Darkone83/EOS/Tools/readme.md

# Eos — Tools

Host-side tooling for building, flashing, and maintaining an Eos modchip. Four tools:

| Tool | What it's for | Who uses it |
|---|---|---|
| **`Recovery/`** | Reflash / un-brick a board over USB — bitstream, BIOS, loader, XbDiag | **End users** |
| **`eos_pack.py`** | Legacy PrometheOS 1.5.x / LZ4 image packer | Chip prep / dev |
| **`eos_pack_v2.py`** | PrometheOS 1.6+ / LZX image packer | Chip prep / dev |
| **`gen_hud.py`** | Regenerate the HDMI serve-HUD gateware | Firmware dev |

---

## Recovery/  — end-user reflash & un-brick

A point-and-click app that writes the Nano 20K's on-board flash over USB. This is the one you
hand to an end user: it recovers a **bricked bitstream** or a **bad BIOS** without an external
programmer, because the Nano's USB-JTAG bridge still works even when the FPGA design is dead.

```
Recovery/
  eos_recovery.py       the GUI
  openFPGALoader.exe    bundled programmer
  *.dll                 its runtime (libusb, libftdi1, libhidapi, zlib, MinGW)
```

**It's self-contained.** The programmer and every DLL it needs ship in this folder, so it runs
on a clean Windows machine with nothing installed but Python and PySide6 — or nothing at all,
if you freeze it.

**Run it**

```bash
pip install pyside6
python eos_recovery.py
```

Or freeze to a no-Python distributable:

```bash
pyinstaller --onedir --windowed --add-data "openFPGALoader.exe;." --add-data "*.dll;." eos_recovery.py
```

### What the four buttons do

Each section is independent, so you recover exactly what's broken.

| Card | Source | Where it lands |
|---|---|---|
| **Bitstream** | a local `.fs` you pick | the FPGA config flash |
| **BIOS** | a local `.bin` you pick | the offset in the box (defaults to `0x200000`) |
| **Loader** | downloaded — `loader.bin` | `0x200000` (bank `0xE`) |
| **XbDiag Lite** | downloaded — `xbdlite.bin` | `0x400000` (bank `0xD`) |

The two download cards need no file at all — they pull the current image straight from the
Darkone server (`http://darkone83.myddns.me:8008/EOS/`), flash it, and clean up after
themselves. Use them when you've got nothing to hand, or when you just want the current build.
They need an internet connection; everything else works offline.

Under the hood the two local cards run:

- **Bitstream** → `openFPGALoader -b tangnano20k -f <eos.fs>`
- **BIOS** → `openFPGALoader -b tangnano20k --external-flash -o <offset> <eos.bin>`

The app detects the board, streams the programmer's output live, and shows a clear pass/fail
banner.

> **The Loader card overwrites your BIOS.** `loader.bin` is the full image and lands at
> `0x200000` — the same place the BIOS card writes — so any banks you've flashed go with it.
> The app asks you to confirm before it starts. XbDiag writes to `0x400000`, which is a
> reserved area, so it doesn't ask.

> **Offsets come from the gateware.** `0x200000` is `FLOOR` in `eos_bank_ctrl.v`, and
> `0x400000` is bank `0xD`'s base plus `FLOOR`. If you ever change the bank map in the
> firmware, change the offsets in `eos_recovery.py` to match.

> **Windows driver:** first-time users may need to bind the Nano's JTAG interface to WinUSB
> with **Zadig** before the app can see the board. If Detect says "plug in your board" while a
> board is clearly connected, that's the reason.

---

## eos_pack.py — legacy PrometheOS 1.5 / LZ4 BIOS image packer

Builds a **legacy PrometheOS 1.5.x / LZ4** flashable Eos BIOS image. It takes a **known-good matching 1.5.x template image** (including its kernel and bank geometry) and swaps in **only your launcher XBE**,
LZ4-compressed, into the XeniumOS bank at `0x100000`. Everything else in the image stays
byte-for-byte identical, so the kernel always finds the XBE where it expects it. The one
variable is your XBE.

For the legacy 1.5.x format, the XBE region runs `0x100000`–`0x180000`, so the descriptor plus the compressed XBE has to
fit in **512 KB**. The kernel sits at `0x180000`. The output is the full image you flash to the
BIOS offset.

**Requirements:** `pip install lz4` (legacy packer only).

**Usage**

```bash
# Pack your loader XBE into a template -> flashable image
python eos_pack.py pack   <template.bin> <your_loader.xbe> <out.bin>

# Extract the embedded XBE back out
python eos_pack.py unpack <image.bin> <out.xbe>

# Inspect an image: XBE size, magic, md5, and the descriptor
python eos_pack.py verify <image.bin>
```

`pack` is the one that checks itself. After writing the image it decompresses the payload back
out and compares md5 against your original XBE, so a bad compress can't slip through. It also
refuses to write if the compressed XBE won't fit the 512 KB bank, and warns (but continues) if
your file doesn't start with `XBEH`.

`verify` is an inspection command, not a test — it prints the payload's size, magic, and md5,
prints the descriptor, and re-compresses to show you how much of the bank you're using. It
doesn't compare anything, and it doesn't return a failure code. If you want a pass/fail, use
`unpack` and diff against your XBE.

> `pack` zero-fills the rest of the XBE bank before writing the payload. That's fine for a
> whole-image flash, since the programmer erases first.

**Do not use this LZ4 packer with PrometheOS 1.6+ LZX templates.** Use `eos_pack_v2.py` below.

---

## eos_pack_v2.py — PrometheOS 1.6+ / LZX BIOS image packer

Use this tool with a **known-good PrometheOS 1.6 or newer, 2 MiB Xenium-format template**.
PrometheOS 1.6+ stores the embedded XBE as a framed **LZX** stream instead of the older
LZ4 stream. The tool replaces only the two XBE payload ranges; it does not rebuild or
replace the template's bootloader, recovery content, or settings/spare region.

### Image layout

| Offset range | Content | Packer behavior |
|---|---|---|
| `0x100000–0x17FFFF` | Embedded XBE, first 512 KiB | Replaced |
| `0x180000–0x1BFFFF` | Bootloader, 256 KiB | **Preserved** |
| `0x1C0000–0x1DFFFF` | Recovery / other template data, 128 KiB | **Preserved** |
| `0x1E0000–0x1F7FFF` | Embedded XBE continuation, final 96 KiB | Replaced |
| `0x1F8000–0x1FFFFF` | Settings / spare, 32 KiB | **Preserved** |

The logical XBE bank totals **608 KiB** (512 + 96 KiB). Its first eight bytes contain
little-endian uncompressed and compressed sizes, followed by LZX frames (each with a
compressed-size and uncompressed-size pair). The remaining logical bank space is zero-padded.
This differs from the legacy **512 KiB LZ4** region and must not be packed as one continuous
physical range across the bootloader.

### Requirements

- **Windows** and **Python 3**.
- Windows' built-in `makecab.exe` and `expand.exe` on the system path.
- No Python `lz4` dependency or third-party compression DLL for the V2 path.

The compressor uses a **128 KiB LZX window** (`CompressionMemory=17`) and 32 KiB uncompressed
frame chunks, following the format expected by the PrometheOS 1.6+ bootloader.

### Usage

```bash
# Insert a loader XBE into a matching PrometheOS 1.6+ template
python eos_pack_v2.py pack <template.bin> <loader.xbe> <out.bin>

# Extract the embedded loader XBE
python eos_pack_v2.py unpack <image.bin> <out.xbe>

# Inspect and decode the LZX-packed image
python eos_pack_v2.py verify <image.bin>
```

`pack` checks the 2 MiB template size and the 608 KiB XBE capacity, performs a
compression/decompression round-trip, and verifies that the recovered XBE matches the
input. The original bootloader and other protected template ranges are left untouched.

`verify` parses the LZX descriptor and frames and decodes the embedded XBE. It is a format/
decode check; to confirm an image contains your intended XBE, `unpack` it and compare the
extracted file against the intended input.

> **Important:** Keep a known-good copy of the input template and verify the packed image
> before flashing. The packer outputs a complete 2 MiB firmware image, so writing it to
> the BIOS flash region can replace whatever user BIOS data was present in that image.
> The packer's template preservation does not make a whole-image flash nondestructive.

---

## gen_hud.py  — serve-HUD generator

Regenerates the HDMI serve dashboard gateware (`eos_serve_hud.v`). The panels, layout, and
colours all live in **this script**, not in the `.v`. To change the HUD, edit the cell
definitions here and regenerate.

**Never hand-edit `eos_serve_hud.v`.** It happened once: an I2C panel was added straight to the
`.v` and never brought back here, which left the generator 62 cells and 9 module ports behind
the firmware. Running it then produced a module the top level couldn't build against.

Panels: title, BOOT-LINK (rev / D0 / LFRAME aborts), SERVE (bank / rate / last), FLASH ENGINE,
I2C ENGINE (address / version / last command / RX count / select), SDRAM preload bar,
address-space serve map, serve log, stability. Colour attrs: `0` normal · `1` header
(white-on-purple) · `2` purple accent · `3` green · `4` amber · `5` red · `7` dim.

**Requirements:** none (Python standard library)

**Usage**

```bash
# Write straight over the firmware's copy
python gen_hud.py ../Source/src/eos_serve_hud.v

# Or with no argument, drops eos_serve_hud.v in the current folder
python gen_hud.py
```

It prints the cell count when it's done (607 at the time of writing) and warns about any cell
written twice. Six overlaps at row 4 are expected — the D0 field paints blanks and then
overwrites them in the same scan pass. Anything else is a layout bug. A cell outside the
160×45 grid is a hard error.

---

## Requirements summary

| | Needs |
|---|---|
| `Recovery/eos_recovery.py` | `pip install pyside6` (programmer + DLLs bundled). Internet for the Loader / XbDiag cards. |
| `eos_pack.py` (legacy 1.5.x/LZ4) | `pip install lz4` |
| `eos_pack_v2.py` (1.6+/LZX) | Windows + Python 3; built-in `makecab.exe` and `expand.exe` |
| `gen_hud.py` | Python 3 standard library only |

---

## Credits

Eos tooling © Team Resurgent / Darkone83. `openFPGALoader` is the universal FPGA programming
utility by Gwenhael Goavec-Merou and contributors — <https://github.com/trabucayre/openFPGALoader>
— bundled here under its own licence for end-user convenience.
