Darkone83/EOS/images/Bottom.png

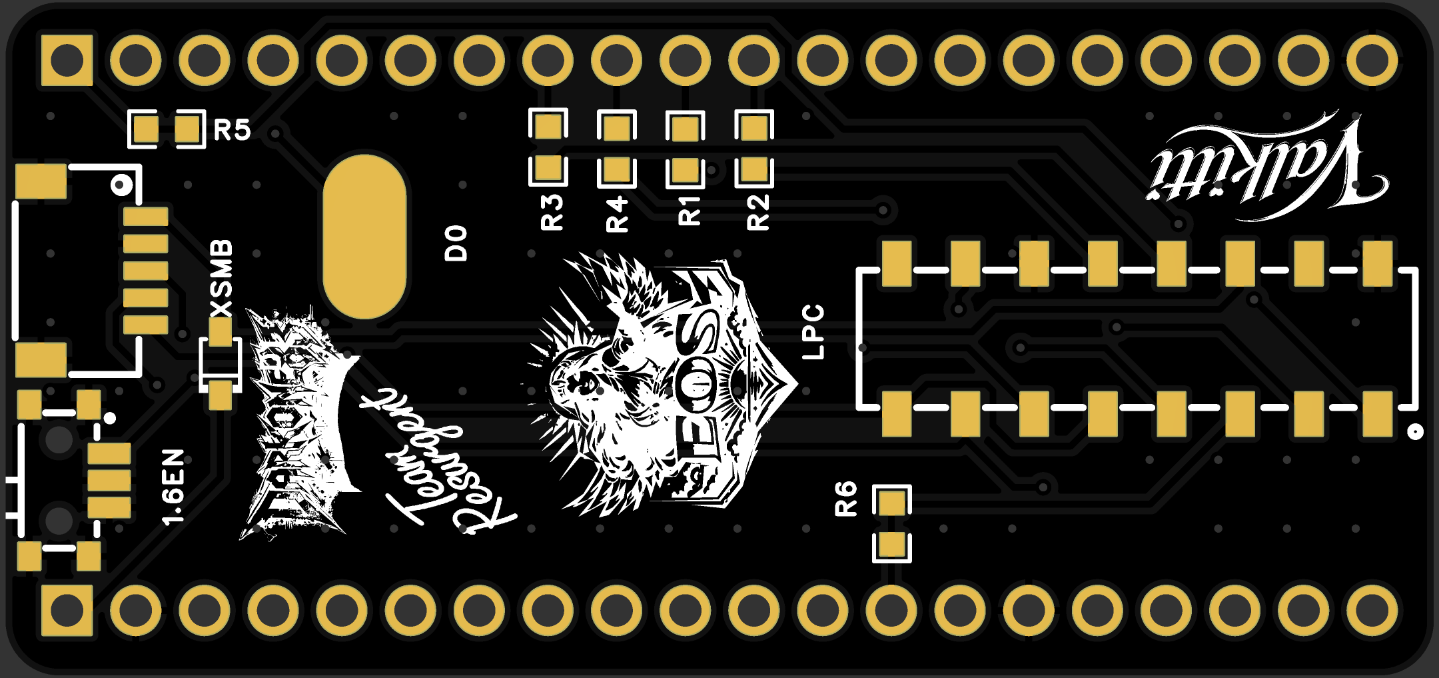
images/Bottom.png
