Darkone83/EOS/images/Bottom_V2.png

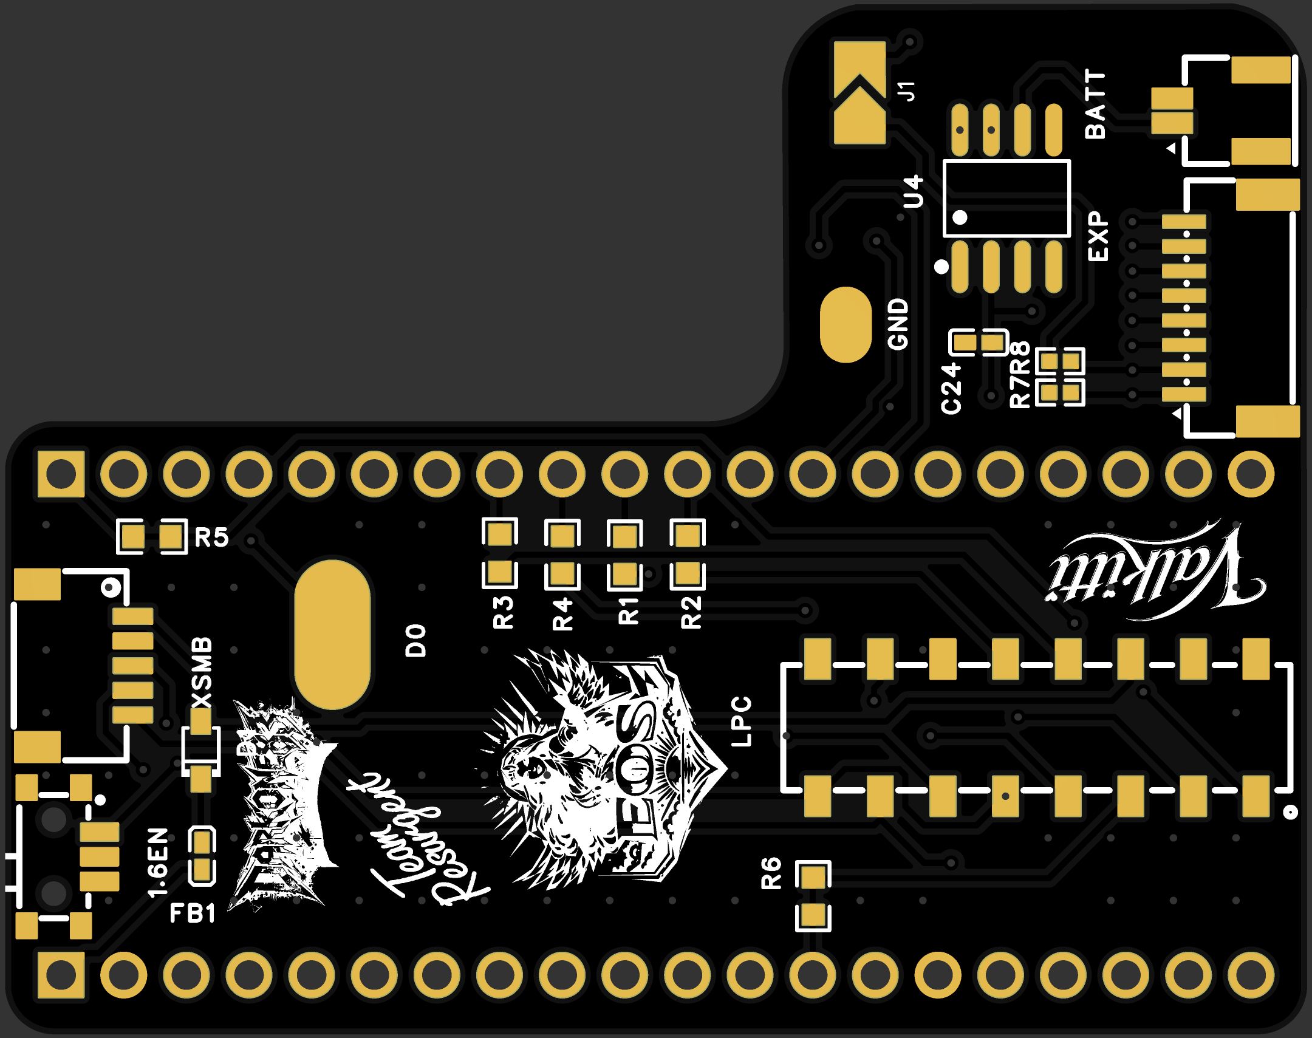
images/Bottom_V2.png
