Darkone83/EOS/images/Top.png

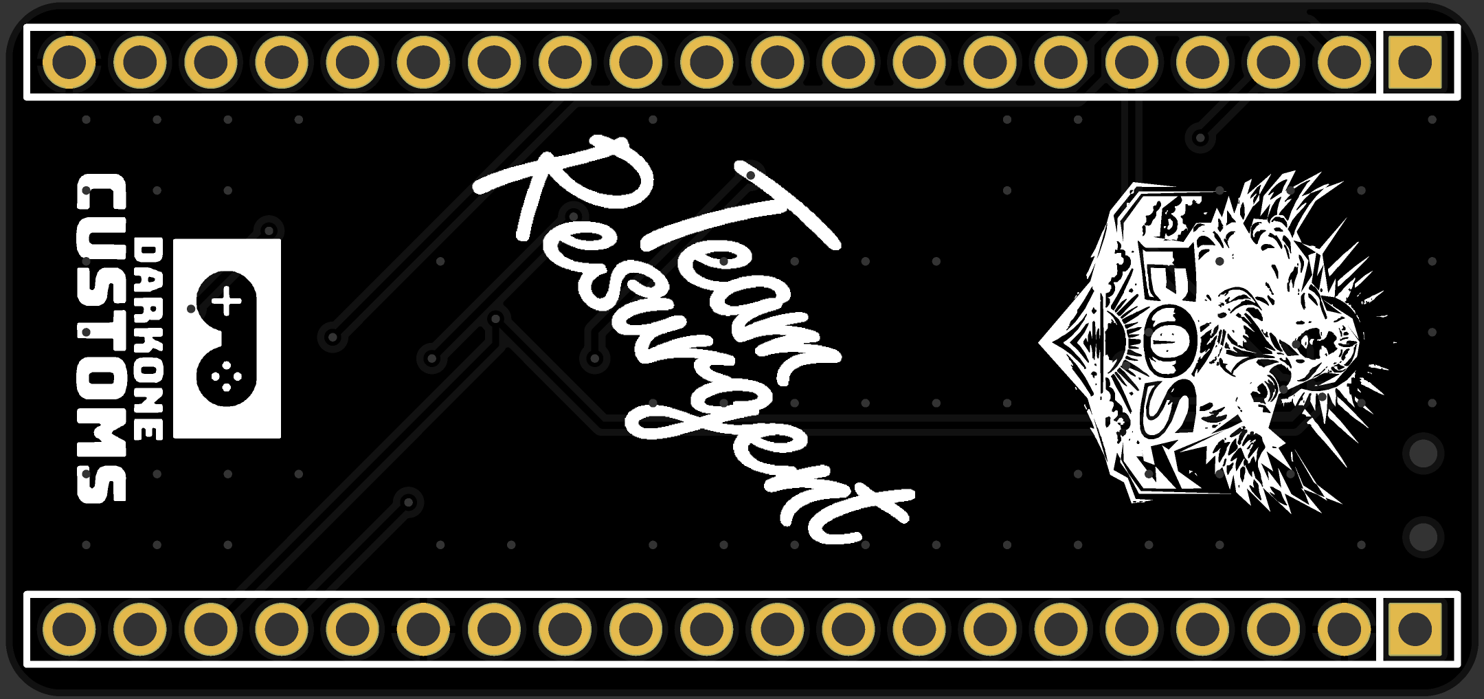
images/Top.png
