Darkone83/EOS/images/Top_V2.png

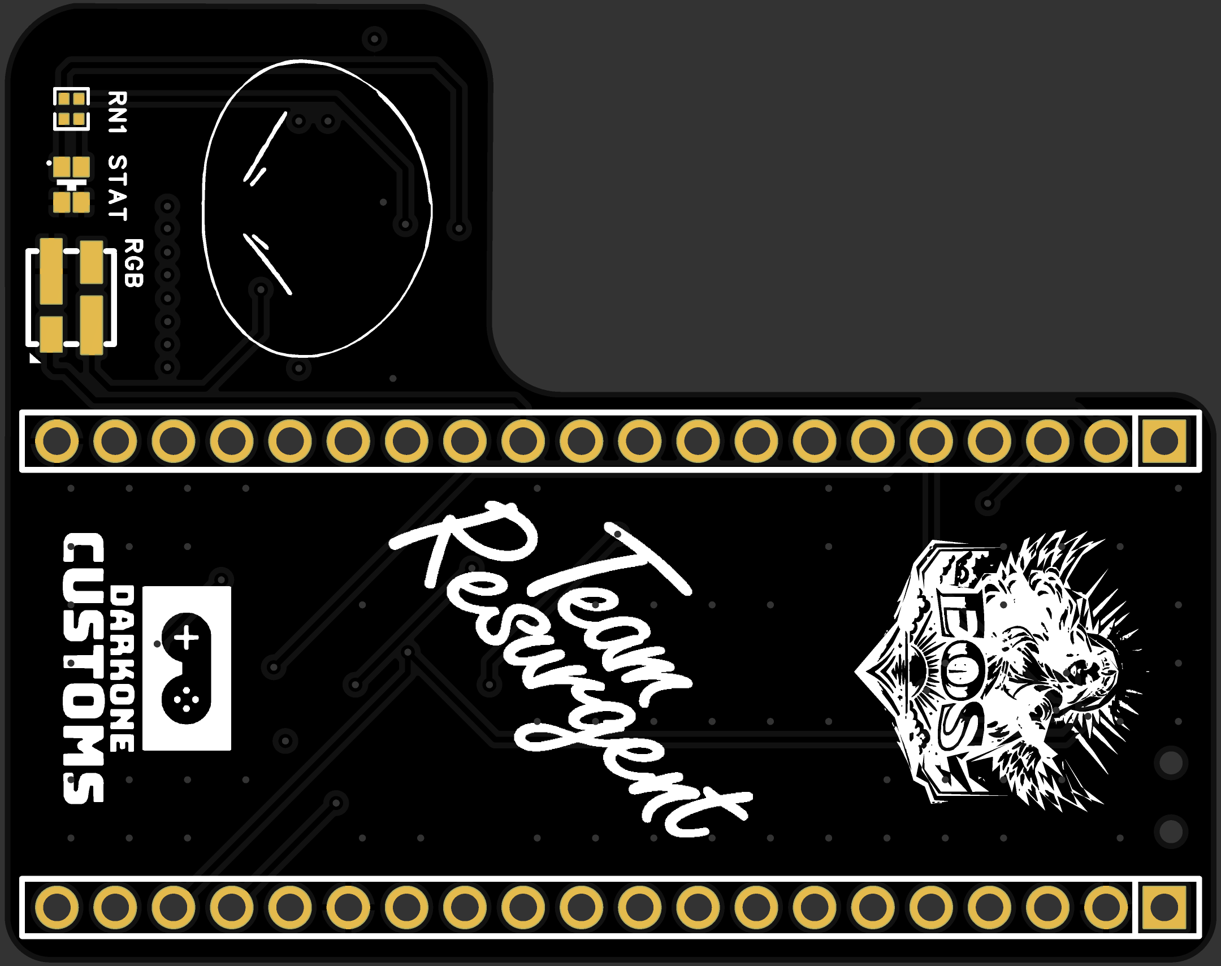
images/Top_V2.png
