Darkone83/EOS/Schematics/EOS_V1.png

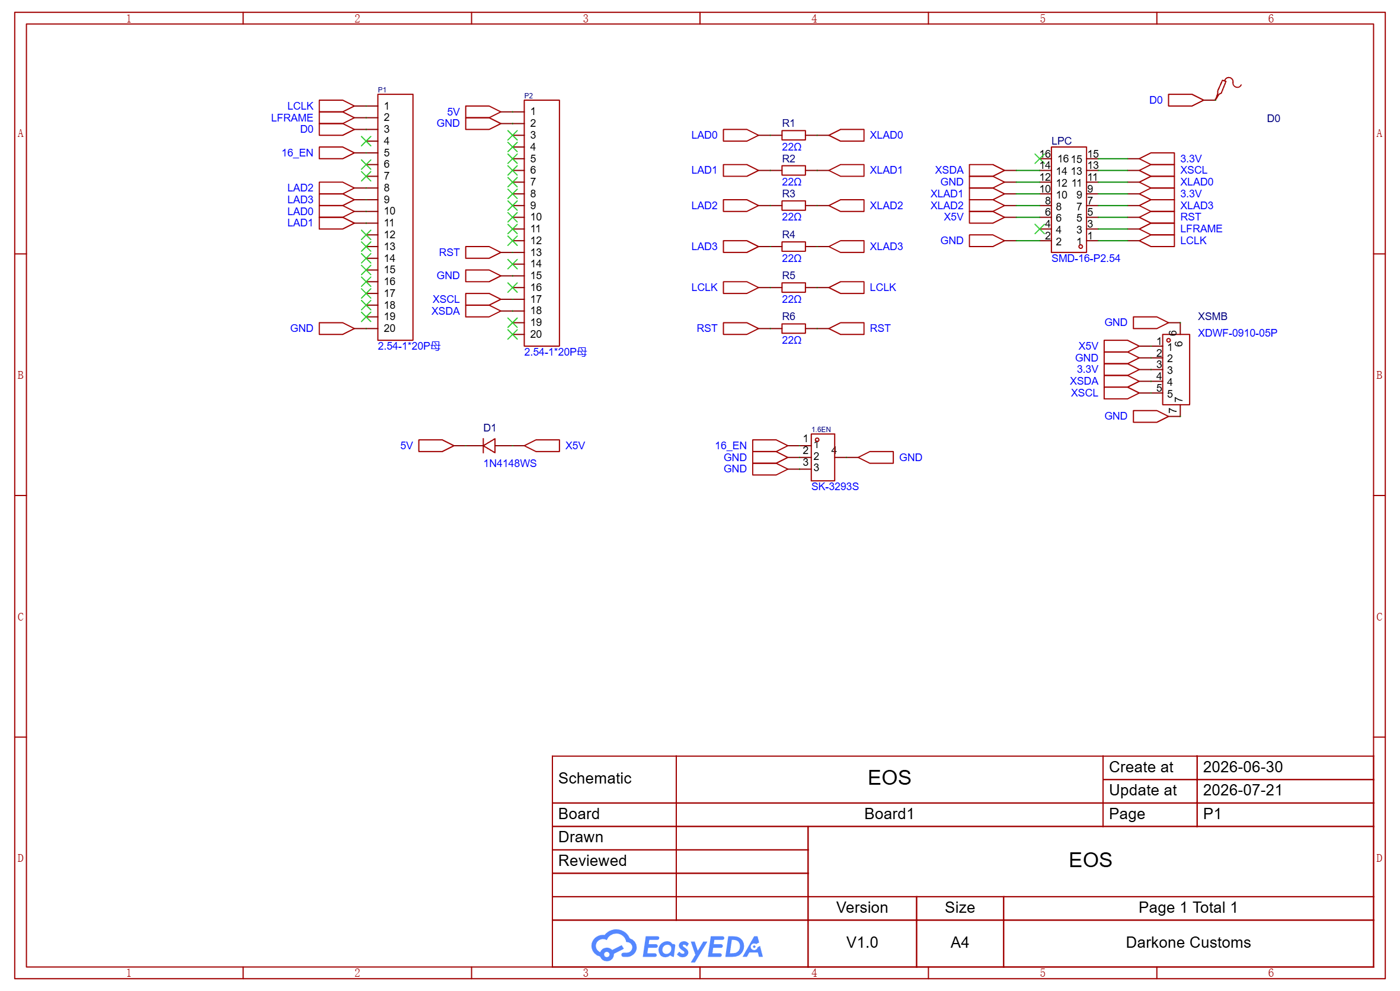
Schematics/EOS_V1.png
