Darkone83/EOS/Schematics/EOS_V2.png

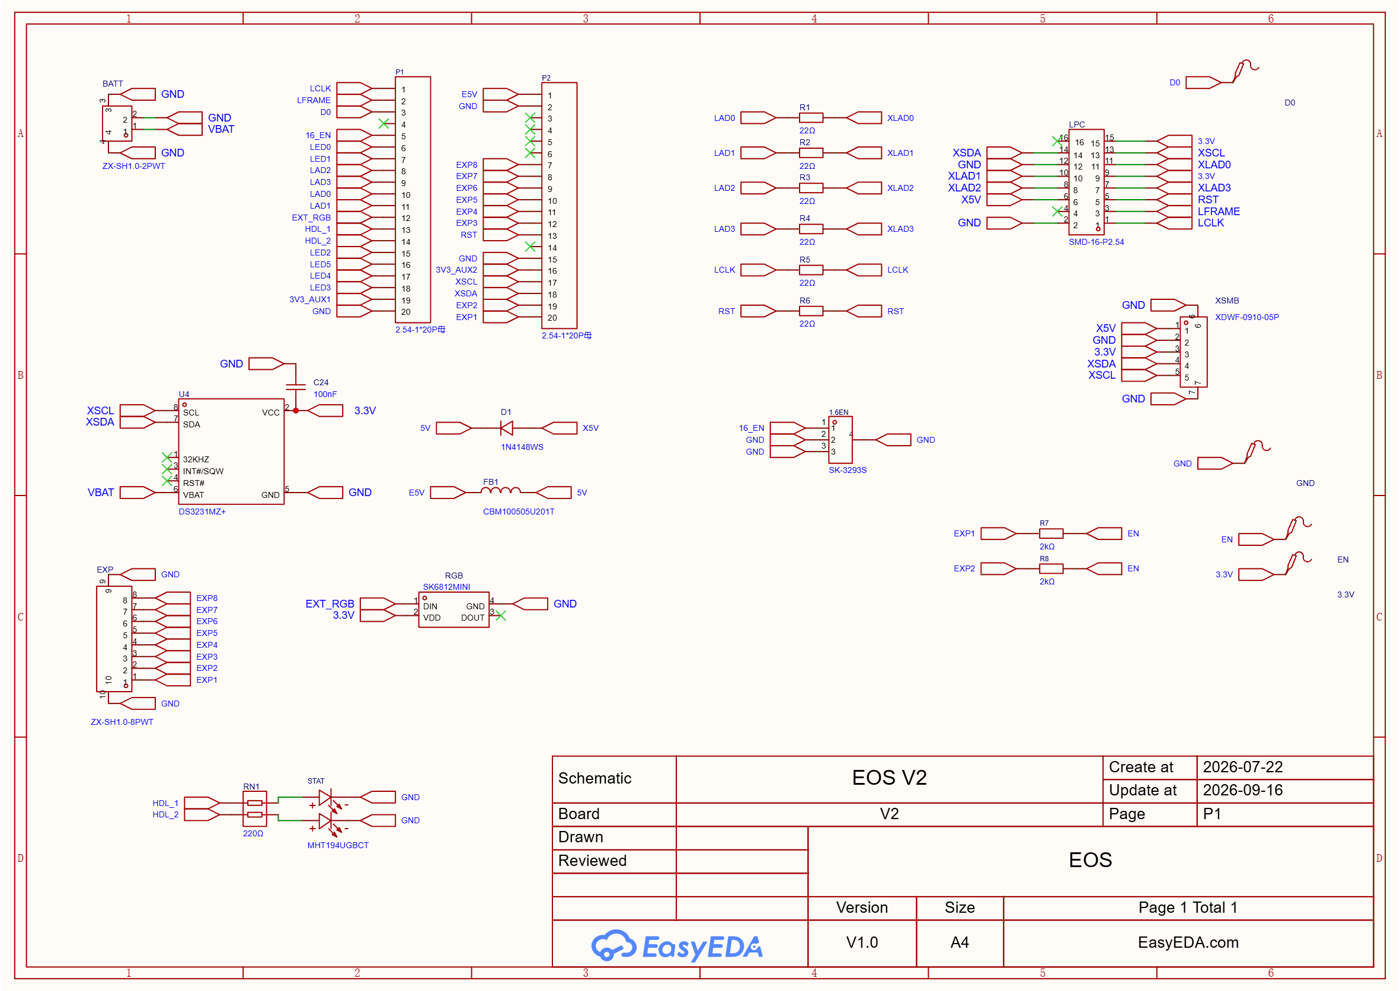
Schematics/EOS_V2.png
