Darkone83/EOS/Gerbers/V2/BOM_V2.xlsx

No. | Quantity | Comment | Designator | Footprint | Value | Manufacturer Part | Manufacturer | Supplier Part | Supplier
1 | 1 | SK-3293S | 1.6EN | SW-SMD_SK-3293S |  | SK-3293S | XKB Connectivity(中国星坤) | C466006 | LCSC
2 | 4 | Test-Point | 3.3V,D0,EN,GND | Test-Point-0.5mm
3 | 1 | ZX-SH1.0-2PWT | BATT | CONN-SMD_2P-P1.00_HX-1.0-2P-WT |  | ZX-SH1.0-2PWT | Megastar(兆星) | C7430444 | LCSC
4 | 1 | 100nF | C24 | C0402 | 100nF | CL05B104KO5NNNC | SAMSUNG(三星) | C1525 | LCSC
5 | 1 | 1N4148WS | D1 | SOD-323_L1.8-W1.3-LS2.5-RD |  | 1N4148WS | CJ(江苏长电/长晶) | C2128 | LCSC
6 | 1 | ZX-SH1.0-8PWT | EXP | CONN-SMD_8P-P1.00_MEGASTAR_ZX-SH1.0-8PWT |  | ZX-SH1.0-8PWT | Megastar(兆星) | C7430450 | LCSC
7 | 1 | CBM100505U201T | FB1 | L0402 |  | CBM100505U201T | FH(风华) | C394402 | LCSC
8 | 1 | SMD-16-P2.54 | LPC | HDR-TH_16P-P2.54-V-F-R2-C8-S2.54-LS6.7 |  | SMD-16-P2.54 |  | C9900001406 | LCSC
9 | 2 | 2.54-1*20P母 | P1,P2 | HDR-TH_20P-P2.54-V-F |  | 2.54-1*20P母 | BOOMELE(博穆精密) | C50984 | LCSC
10 | 6 | 22Ω | R1,R2,R3,R4,R5,R6 | R0603 | 22Ω | RC0603FR-0722RL | YAGEO(国巨) | C107701 | LCSC
11 | 2 | 2kΩ | R7,R8 | R0402 | 2kΩ | 0402WGF2001TCE | UNI-ROYAL(厚声) | C4109 | LCSC
12 | 1 | SK6812MINI | RGB | LED-SMD_4P-L3.7-W3.5-P1.75-BR-SK6812MINI |  | SK6812mini | 欧思科光电 | C2886570 | LCSC
13 | 1 | 220Ω | RN1 | RES-ARRAY-SMD_0402-L1.0-W1.0-BL | 220Ω | YC122-JR-07220RL | YAGEO(国巨) | C1731723 | LCSC
14 | 1 | MHT194UGBCT | STAT | LED-ARRAY-SMD_0605-4P-L1.6-W1.5-BL-1 |  | MHT194UGBCT | MEIHUA(美华) | C2764896 | LCSC
15 | 1 | DS3231MZ+ | U4 | SOIC-8_L4.9-W3.9-P1.27-LS6.0-BL |  | DS3231MZ+ | ADI(亚德诺)/MAXIM(美信) | C722467 | LCSC
16 | 1 | XDWF-0910-05P | XSMB | CONN-SMD_XDWF-0910-05P |  | XDWF-0910-05P | LX(连欣科技) | C7527620 | LCSC
