Darkone83/EOS/Source/src/eos_bank_ctrl.v

// eos_bank_ctrl.v -- Eos bank-management controller (flash erase/program/poll).
// =====================================================================
// Loader flash CONTROL PLANE. Does NOT duplicate the serve path: the 0xEF bank
// register and the logical->physical SERVE translation live in
// eos_sdram_backend.v (hardware-validated). This module owns what the backend
// does not -- writing the flash:
//   * ERASE a bank   (loop 64K block-erase 0xD8 over the bank's size)
//   * PROGRAM a page (0x02, a 256-byte page from the page buffer)
//   * READ a page    (0x03, clock 256 bytes back into the page buffer for host
//                     read-back; cmd_op = 2)
//   * real STATUS poll (0x05, wait WIP bit0 clear after every erase/program)
//   * HARD floor guard: every physical target is FLOOR + bank_base + offset, so
//     it is impossible to address below FLOOR. Chip-erase is not implemented.
// VARIABLE BIOS SIZE: a bank's size comes from its number (256K / 512K / 1MB),
// matching the backend xlate map. ERASE walks (size/64K) blocks; PROGRAM walks
// (size/256) pages. Expansion banks are a later map extension -- the geometry
// functions below are the single place to grow.
// SPI BUS shared with the reader (idle post-preload); taken via bus_req/bus_gnt.
// After a flash, refresh_* hands the region to the backend for SDRAM reload.
// =====================================================================
module eos_bank_ctrl #(
    parameter [23:0]  FLOOR    = 24'h200000,
    parameter integer SCK_DIV  = 2,
    parameter [7:0]   CMD_WREN = 8'h06,
    parameter [7:0]   CMD_PP   = 8'h02,
    parameter [7:0]   CMD_BE   = 8'hD8,
    parameter [7:0]   CMD_RDSR = 8'h05,
    parameter [7:0]   CMD_READ = 8'h03,
    // ---- dynamic bank geometry (Pass 1: FPGA read-only) ----
    // Offsets are relative to FLOOR (same space as bank_base). Blank NOR reads
    // 0xFF so a fresh chip fails the MAGIC check -> legacy static geometry.
    parameter [23:0]  DESC_OFF   = 24'h4C0000,   // descriptor block  (phys 0x6C0000)
    parameter [23:0]  NEWRGN_OFF = 24'h3C0000    // oversized-bank region (phys 0x5C0000)
)(
    input  wire        clk,
    input  wire        cold_rstn,
    // CONTRACT: cmd_bank/cmd_op/cmd_page must be VALID AND STABLE on the cycle
    // before cmd_stb pulses (operands-valid-before-strobe). The loader's LPC
    // decode registers naturally satisfy this; do not derive cmd_stb and cmd_bank
    // from the same combinational decode in the same cycle.
    input  wire        cmd_stb,
    input  wire [1:0]  cmd_op,        // 0=ERASE_BANK 1=PROGRAM_PAGE 2=READ_PAGE
    input  wire [3:0]  cmd_bank,
    input  wire [12:0] cmd_page,
    input  wire        desc_reload,   // pulse (i2c domain): re-read the descriptor block
    input  wire        blk_erase,     // 1 = ERASE only one 64K block at cmd_page's block
    input  wire        pb_wr,
    input  wire [7:0]  pb_addr,
    input  wire [7:0]  pb_din,
    input  wire [7:0]  pb_raddr,      // page-buffer read address (host read-back)
    output wire [7:0]  pb_rdata,      // page-buffer read data
    output reg         busy,
    output reg         done,
    output reg         refused,
    output reg  [7:0]  last_status,
    output reg         refresh_req,
    output reg  [23:0] refresh_base,
    output reg  [23:0] refresh_len,

    // Per-user-slot descriptor export for the SERVE path (eos_sdram_backend).
    // Index [3:0] maps to EF nibbles 0x3..0x6 (bit i = user slot i+1). This lets
    // the backend redirect a normal bank launch (EF 0x3..0x6) to the ext-region
    // SDRAM copy when that slot is an oversized ANCHOR -- no special launch EF.
    output wire [3:0]  ext_anchor,     // 1 = this slot is an oversized anchor
    output wire [7:0]  ext_szc,        // 2 bits per slot: size code (512K/1MB)
    output wire [95:0] ext_base,       // 24 bits per slot: phys base rel FLOOR
    // Bank-LED user colors, packed RGB {R,G,B}. FF,FF,FF = unset (LED off).
    // Read from the descriptor block at boot (and on desc_reload). Blank -> FF.
    output reg  [23:0] bank1_rgb,
    output reg  [23:0] bank2_rgb,
    output reg  [23:0] bank3_rgb,
    output reg  [23:0] bank4_rgb,
    output reg         bus_req,
    input  wire        bus_gnt,
    output reg         flash_cs_n,
    output reg         flash_clk,
    output reg         flash_mosi,
    input  wire        flash_miso,

    // ---- i2c-triggered commit engine (scratch -> flash), gated by i2c ----
    input  wire        commit_go,       // pulse: erase bank + program from scratch + reload
    input  wire [3:0]  commit_bank,     // armed region; physical target derived via bank_base
    input  wire [12:0] commit_pages,    // 256B pages to program from scratch offset 0
    output reg         commit_busy,
    output reg         commit_done,     // 1-cycle pulse on completion
    output reg         commit_err,      // 1 = a sub-op was refused

    // ---- SDRAM scratch read (eos_sdram_backend, same clk_sd domain) ----
    output reg         scr_rd,
    output reg  [20:0] scr_raddr,
    input  wire [7:0]  scr_rdata,
    input  wire        scr_rvalid,
    input  wire        scr_busy
);
    // bank_base is now 24-bit so a config bank can live above the 2MB Xenium
    // range (engine-reachable for erase/program/read; NOT served -- the serve
    // xlate in eos_sdram_backend stays 21-bit / 2MB). Config bank 0xB sits at
    // the top of the managed region, clear of BIOS (0x000000-0x400000) and the
    // XbDiag reserve below it.
    function [23:0] bank_base; input [3:0] b; begin
        case (b)
            4'h1: bank_base = 24'h180000; 4'h2: bank_base = 24'h100000;
            4'h3: bank_base = 24'h000000; 4'h4: bank_base = 24'h040000;
            4'h5: bank_base = 24'h080000; 4'h6: bank_base = 24'h0C0000;
            4'h7: bank_base = 24'h000000; 4'h8: bank_base = 24'h080000;
            4'h9: bank_base = 24'h4D0000; 4'hA: bank_base = 24'h1C0000;   // 0x9 = EOS script region (phys 0x6D0000, free gap)
            4'hB: bank_base = 24'h5F0000;            // CONFIG banks-table (phys 0x7F0000)
            4'hC: bank_base = 24'h5E0000;            // CONFIG settings   (phys 0x7E0000)
            4'hD: bank_base = 24'h200000;            // XbDiag Lite       (phys 0x400000, reserve)
            4'hE: bank_base = 24'h000000;            // LOADER full image (phys 0x200000, slot 0)
            4'h0: bank_base = 24'h3C0000;            // NEW REGION oversized banks (phys 0x5C0000)
            4'hF: bank_base = 24'h4C0000;            // DESCRIPTOR block (phys 0x6C0000)
            default: bank_base = 24'h000000;
        endcase
    end endfunction
    function [23:0] bank_size; input [3:0] b; begin
        case (b)
            4'h2,4'h7,4'h8: bank_size = 24'h080000;  // 512K
            4'h9:          bank_size = 24'h020000;  // EOS script region: 128K (2x 64K blocks)
            4'hD:          bank_size = 24'h1C0000;  // XbDiag: full-image span (28x64K), 2nd slot
            4'hE:          bank_size = 24'h1C0000;  // LOADER: full-image span (28x64K), slot 0
            4'hB,4'hC:      bank_size = 24'h010000;  // CONFIG: one 64K block each
            4'h0:          bank_size = 24'h100000;  // NEW REGION: 1MB oversized area
            4'hF:          bank_size = 24'h010000;  // DESCRIPTOR: one 64K block
            default:        bank_size = 24'h040000;  // 256K
        endcase
    end endfunction

    // ===== i2c-triggered commit supervisor (scratch -> flash) ==============
    // Drives the SPI FSM below via muxed command signals so the flash logic is
    // untouched. commit_bank is the ONLY selector -- the physical range derives
    // from bank_base (FLOOR-guarded), never passed raw, so i2c stays the gate.
    // Sequence: ERASE bank -> per page {fill pbuf from scratch, PROGRAM} -> SYNC.
    // Loader LPC commands are muxed out while commit_active.
    localparam CS_IDLE=3'd0, CS_ERASE=3'd1, CS_FILL=3'd2, CS_PROG=3'd3,
               CS_SYNC=3'd4, CS_DONE=3'd5, CS_ERR=3'd6;
    reg [2:0]  cst;
    reg        commit_active;
    reg [3:0]  cbank;
    reg [12:0] cpages, cpg;
    reg [8:0]  cfill;
    reg [1:0]  cstep;
    reg        sup_cmd_stb, sup_pb_wr;
    reg [1:0]  sup_cmd_op;
    reg [12:0] sup_cmd_page;
    reg [7:0]  sup_pb_addr, sup_pb_din;

    wire        eff_cmd_stb  = commit_active ? sup_cmd_stb  : cmd_stb;
    wire [1:0]  eff_cmd_op   = commit_active ? sup_cmd_op   : cmd_op;
    wire [3:0]  eff_cmd_bank = commit_active ? cbank        : cmd_bank;
    wire [12:0] eff_cmd_page = commit_active ? sup_cmd_page : cmd_page;
    wire        eff_pb_wr    = commit_active ? sup_pb_wr    : pb_wr;
    wire [7:0]  eff_pb_addr  = commit_active ? sup_pb_addr  : pb_addr;
    wire [7:0]  eff_pb_din   = commit_active ? sup_pb_din   : pb_din;

    // ===== dynamic bank descriptor (Pass 1: read-only) =====================
    // Loaded once at boot from the descriptor block. When invalid (blank flash),
    // descriptor_valid=0 and ALL geometry falls back to the static tables below,
    // so behavior is byte-identical to the legacy design. Only user slots 1..4
    // are governed by the descriptor; loader/xbdiag/config always use statics.
    //
    // Per-slot entry (from flash, 8 bytes each):
    //   [0] state     0=free 1=native256 2=oversized-anchor 3=shadowed
    //   [1] size_code 0=256K 1=512K 2=1M
    //   [4..6] phys_base (24-bit, relative to FLOOR, little-endian)
    localparam DS_FREE=2'd0, DS_NATIVE=2'd1, DS_ANCHOR=2'd2, DS_SHADOW=2'd3;

    reg        descriptor_valid;
    reg [1:0]  slot_state [1:4];
    reg [1:0]  slot_szc   [1:4];
    reg [23:0] slot_base  [1:4];   // relative to FLOOR

    // Export the parsed slots for the serve path. slot_state[1..4] correspond to
    // EF nibbles 0x3..0x6 (descriptor slots 0..3). Only valid when descriptor_valid.
    assign ext_anchor[0] = descriptor_valid && (slot_state[1] == DS_ANCHOR);
    assign ext_anchor[1] = descriptor_valid && (slot_state[2] == DS_ANCHOR);
    assign ext_anchor[2] = descriptor_valid && (slot_state[3] == DS_ANCHOR);
    assign ext_anchor[3] = descriptor_valid && (slot_state[4] == DS_ANCHOR);
    assign ext_szc  = {slot_szc[4],  slot_szc[3],  slot_szc[2],  slot_szc[1]};
    assign ext_base = {slot_base[4], slot_base[3], slot_base[2], slot_base[1]};

    // size_code -> byte length
    function [23:0] szc_len; input [1:0] c; begin
        case (c)
            2'd0: szc_len = 24'h040000;   // 256K
            2'd1: szc_len = 24'h080000;   // 512K
            2'd2: szc_len = 24'h100000;   // 1M
            default: szc_len = 24'h040000;
        endcase
    end endfunction

    // Is this a user slot (1..4) the descriptor is allowed to govern?
    wire eff_is_user_slot = (eff_cmd_bank >= 4'd1) && (eff_cmd_bank <= 4'd4);
    wire [2:0] eff_slot_ix = eff_cmd_bank[2:0];   // 1..4

    // Descriptor-resolved geometry for the selected user slot (valid only when
    // descriptor_valid && eff_is_user_slot). Occupied = native or anchor.
    wire       eff_slot_occupied = eff_is_user_slot &&
                   ((slot_state[eff_slot_ix] == DS_NATIVE) ||
                    (slot_state[eff_slot_ix] == DS_ANCHOR));
    wire [23:0] dyn_base = FLOOR + slot_base[eff_slot_ix];
    wire [23:0] dyn_size = (slot_state[eff_slot_ix] == DS_NATIVE)
                             ? 24'h040000
                             : szc_len(slot_szc[eff_slot_ix]);

    // Use the descriptor ONLY when it is valid, the bank is a user slot, and that
    // slot is actually occupied. Everything else -> legacy static tables. This
    // guarantees: blank descriptor -> pure legacy; non-user banks -> pure legacy;
    // selecting a free/shadowed slot -> legacy (harmless; the host gates real ops).
    wire use_dynamic = descriptor_valid && eff_is_user_slot && eff_slot_occupied;

    wire [23:0] sel_phys_base = use_dynamic ? dyn_base
                                            : (FLOOR + bank_base(eff_cmd_bank));
    wire [23:0] sel_size      = use_dynamic ? dyn_size
                                            : bank_size(eff_cmd_bank);
    wire [8:0]  n_blocks      = sel_size[23:16];   // size / 64K
    wire        op_below_floor = (sel_phys_base < FLOOR);

    reg [7:0] pbuf [0:255];
    // External fill (program) writes via pb_wr; internal fill (read-back) writes
    // captured flash bytes via rd_we. The two never overlap (fill precedes GO;
    // read-capture happens during a READ op). pb_rdata streams the buffer back.
    reg        rd_we; reg [7:0] rd_waddr, rd_wdata;
    always @(posedge clk) begin
        if (eff_pb_wr)  pbuf[eff_pb_addr] <= eff_pb_din;
        else if (rd_we) pbuf[rd_waddr] <= rd_wdata;
    end
    assign pb_rdata = pbuf[pb_raddr];

    localparam integer PERIOD = 2*SCK_DIV;
    reg  [15:0] pc; reg [3:0] bit_i; reg [7:0] tx_byte, rx_byte, sh;
    reg         shift_go, shift_busy, shift_done;
    wire        pc_last = (pc == PERIOD-1);
    wire        sck_hi  = (pc >= SCK_DIV);

    always @(posedge clk or negedge cold_rstn) begin
        if (!cold_rstn) begin
            pc<=0; bit_i<=0; shift_busy<=0; shift_done<=0; flash_clk<=0; flash_mosi<=0; rx_byte<=0; sh<=0;
        end else begin
            shift_done <= 1'b0;
            if (shift_go && !shift_busy) begin
                shift_busy<=1'b1; sh<=tx_byte; bit_i<=4'd0; pc<=0; flash_mosi<=tx_byte[7]; flash_clk<=1'b0;
            end else if (shift_busy) begin
                flash_clk <= sck_hi;
                if (pc==0) flash_mosi <= sh[7];
                if (pc==SCK_DIV) rx_byte <= {rx_byte[6:0], flash_miso};
                if (pc_last) begin
                    pc<=0; sh<={sh[6:0],1'b0};
                    if (bit_i==4'd7) begin shift_busy<=0; shift_done<=1; flash_clk<=0; end
                    else bit_i<=bit_i+1'b1;
                end else pc<=pc+1'b1;
            end
        end
    end

    localparam OP_ERASE = 2'd0, OP_PROG = 2'd1, OP_READ = 2'd2, OP_SYNC = 2'd3;
    localparam S_IDLE=5'd0,S_REQ=5'd1,S_WREN=5'd2,S_WREN2=5'd3,S_CMD=5'd4,
               S_A2=5'd5,S_A1=5'd6,S_A0=5'd7,S_PDATA=5'd8,S_CSUP=5'd9,
               S_POLL0=5'd10,S_POLL1=5'd11,S_POLLC=5'd12,S_NEXT=5'd13,
               S_DONE=5'd14,S_REFUSE=5'd15,S_KICK=5'd16,
               S_RCMD=5'd17,S_RA2=5'd18,S_RA1=5'd19,S_RA0=5'd20,
               S_RDATA=5'd21,S_RCAP=5'd22,S_RCSUP=5'd23,
               // ---- boot-time descriptor load (Pass 1) ----
               S_DBOOT=5'd24,   // wait for bus grant, start read
               S_DCMD=5'd25,S_DA2=5'd26,S_DA1=5'd27,S_DA0=5'd28,
               S_DRD=5'd29,S_DCAP=5'd30,S_DFIN=5'd31,
               // ---- boot-time LED color-block load (after descriptor) ----
               S_LBOOT=6'd32,S_LCMD=6'd33,S_LA2=6'd34,S_LA1=6'd35,S_LA0=6'd36,
               S_LRD=6'd37,S_LCAP=6'd38,S_LFIN=6'd39,
               // ---- SPI transaction guard gaps (diagnostic) ----
               S_WGAP=6'd40,S_PGAP=6'd41;

    reg [5:0]  st, ret; reg [1:0] op_l;
    reg [3:0]  gap_cnt;   // CS-high guard counter between SPI transactions
    reg [23:0] addr_l; reg [8:0] blocks_left; reg [8:0] pbyte;
    reg [23:0] flashed_base, flashed_len;
    reg [8:0]  rd_idx;     // read-back byte counter (0..256)

    // descriptor-load working state
    localparam DESC_BYTES = 7'd64;         // read 64 bytes of the descriptor block
    // Physical descriptor address, byte-sliced for the 0x03 READ command below.
    // Explicit slices instead of >>16 / >>8 / &0xFF so no implicit truncation.
    localparam [23:0] DESC_PHYS = FLOOR + DESC_OFF;   // 0x200000 + 0x4C0000 = 0x6C0000
    reg [6:0]  db_idx;                     // 0..63
    reg [7:0]  db_buf [0:63];              // raw descriptor bytes
    reg        desc_loaded;                // 1 once the boot load has completed

    // desc_reload arrives from the i2c clock domain; synchronize and edge-detect it
    // into a sticky reload_pending that the idle FSM consumes by re-running S_DBOOT.
    reg [2:0]  drl_sync;
    reg        reload_pending;
    always @(posedge clk or negedge cold_rstn) begin
        if (!cold_rstn) begin drl_sync<=3'd0; end
        else            drl_sync<={drl_sync[1:0], desc_reload};
    end
    wire drl_edge = (drl_sync[2:1]==2'b01);   // rising edge in this domain

    always @(posedge clk or negedge cold_rstn) begin
        if (!cold_rstn) begin
            st<=S_DBOOT; busy<=0; done<=0; refused<=0; last_status<=8'hFF;
            flash_cs_n<=1; bus_req<=0; shift_go<=0; refresh_req<=0; refresh_base<=0; refresh_len<=0;
            addr_l<=0; blocks_left<=0; pbyte<=0; op_l<=0; flashed_base<=0; flashed_len<=0; ret<=S_IDLE;
            gap_cnt<=4'd0;
            rd_we<=0; rd_waddr<=0; rd_wdata<=0; rd_idx<=0;
            db_idx<=0; desc_loaded<=0; descriptor_valid<=0; reload_pending<=0;
            bank1_rgb<=24'hFFFFFF; bank2_rgb<=24'hFFFFFF;
            bank3_rgb<=24'hFFFFFF; bank4_rgb<=24'hFFFFFF;
        end else begin
            done<=1'b0; refresh_req<=1'b0; shift_go<=1'b0; rd_we<=1'b0;
            // Latch a descriptor re-read request from the i2c domain. Consumed only
            // when the flash engine is idle (below), so it never interrupts a live
            // erase/program/read; the host issues DESCRELOAD after it has finished
            // writing the descriptor block.
            if (drl_edge) reload_pending<=1'b1;
            case (st)
                S_IDLE: begin
                    busy<=1'b0; flash_cs_n<=1'b1; bus_req<=1'b0;
                    if (eff_cmd_stb) begin
                        if (op_below_floor ||
                            (eff_cmd_op!=OP_ERASE && eff_cmd_op!=OP_PROG && eff_cmd_op!=OP_READ && eff_cmd_op!=OP_SYNC)) st<=S_REFUSE;
                        else begin
                            busy<=1'b1; op_l<=eff_cmd_op; refused<=1'b0;
                            if (eff_cmd_op==OP_SYNC) begin
                                // no flash access -- hand the WHOLE selected bank to the
                                // backend for one SDRAM reload (the loader calls this once
                                // after a multi-page WriteImage so the served copy matches
                                // flash; per-page reloads can't keep up and get dropped).
                                flashed_base<=sel_phys_base; flashed_len<=sel_size;
                                st<=S_DONE;
                            end else if (eff_cmd_op==OP_ERASE) begin
                                if (blk_erase) begin
                                    // single 64K block: base + (page's block)*64K.
                                    // cmd_page is a 256B page index; block = page>>8.
                                    addr_l<=sel_phys_base + ({eff_cmd_page[12:8],16'd0});
                                    blocks_left<=9'd1;
                                    flashed_base<=sel_phys_base + ({eff_cmd_page[12:8],16'd0});
                                    flashed_len<=24'h010000;
                                end else begin
                                    addr_l<=sel_phys_base; blocks_left<=n_blocks;
                                    flashed_base<=sel_phys_base; flashed_len<=sel_size;
                                end
                                st<=S_REQ;
                            end else begin   // PROGRAM or READ: single page address
                                addr_l<=sel_phys_base + {3'd0,eff_cmd_page,8'd0};
                                flashed_base<=sel_phys_base + {3'd0,eff_cmd_page,8'd0}; flashed_len<=24'd256;
                                st<=S_REQ;
                            end
                        end
                    end else if (reload_pending) begin
                        // Idle and a descriptor re-read was requested: clear the flag
                        // and re-run the boot loader path to refresh geometry from the
                        // freshly-written descriptor block (no reboot needed).
                        // Set busy so the host can poll STATUS and wait for the reload
                        // to finish before issuing the next flash op (no bus race).
                        busy<=1'b1;
                        reload_pending<=1'b0;
                        db_idx<=7'd0;
                        st<=S_DBOOT;
                    end
                end
                S_REQ:  begin bus_req<=1'b1; if (bus_gnt) st<=(op_l==OP_READ)?S_RCMD:S_WREN; end
                S_WREN: begin flash_cs_n<=1'b0; tx_byte<=CMD_WREN; ret<=S_WREN2; st<=S_KICK; end
                S_WREN2: begin
                    flash_cs_n<=1'b1;
                    gap_cnt<=4'd0;
                    st<=S_WGAP;
                end
                // Hold /CS high for 8 clk cycles after WREN before ERASE/PROGRAM.
                // Diagnostic guard only: isolates inter-command CS-high timing.
                S_WGAP: begin
                    flash_cs_n<=1'b1;
                    if (gap_cnt==4'd7) st<=S_CMD;
                    else gap_cnt<=gap_cnt+1'b1;
                end
                S_CMD:  begin flash_cs_n<=1'b0; tx_byte<=(op_l==OP_ERASE)?CMD_BE:CMD_PP; ret<=S_A2; st<=S_KICK; end
                S_A2:   begin tx_byte<=addr_l[23:16]; ret<=S_A1; st<=S_KICK; end
                S_A1:   begin tx_byte<=addr_l[15:8];  ret<=S_A0; st<=S_KICK; end
                S_A0:   begin
                    tx_byte<=addr_l[7:0];
                    if (op_l==OP_ERASE) ret<=S_CSUP;
                    else begin pbyte<=9'd0; ret<=S_PDATA; end
                    st<=S_KICK;
                end
                S_PDATA: begin
                    if (pbyte==9'd256) st<=S_CSUP;
                    else begin tx_byte<=pbuf[pbyte[7:0]]; ret<=S_PDATA; pbyte<=pbyte+1'b1; st<=S_KICK; end
                end
                S_CSUP: begin
                    flash_cs_n<=1'b1;
                    gap_cnt<=4'd0;
                    st<=S_PGAP;
                end
                // Hold /CS high for 8 clk cycles after ERASE/PROGRAM before RDSR.
                S_PGAP: begin
                    flash_cs_n<=1'b1;
                    if (gap_cnt==4'd7) st<=S_POLL0;
                    else gap_cnt<=gap_cnt+1'b1;
                end
                S_POLL0: begin flash_cs_n<=1'b0; tx_byte<=CMD_RDSR; ret<=S_POLL1; st<=S_KICK; end
                S_POLL1: begin tx_byte<=8'h00; ret<=S_POLLC; st<=S_KICK; end
                S_POLLC: begin
                    last_status<=rx_byte;
                    if (rx_byte[0]) begin tx_byte<=8'h00; ret<=S_POLLC; st<=S_KICK; end
                    else begin flash_cs_n<=1'b1; st<=S_NEXT; end
                end
                S_NEXT: begin
                    if (op_l==OP_ERASE && blocks_left>9'd1) begin
                        blocks_left<=blocks_left-1'b1; addr_l<=addr_l+24'h010000; st<=S_WREN;
                    end else st<=S_DONE;
                end
                S_DONE: begin
                    bus_req<=1'b0; busy<=1'b0; done<=1'b1;
                    // ONLY the explicit SYNC reloads SDRAM. ERASE must not -- its
                    // reload races the page-program ops that immediately follow it
                    // (bus contention + a still-pending erase reload makes the final
                    // SYNC's request get dropped by the in-flight guard, leaving the
                    // served copy stale -> warm-reset launch frags while cold boot,
                    // which re-preloads everything, works). WriteImage ends with one
                    // SYNC over the finished image; a deleted bank isn't served so it
                    // needs no reload.
                    if (op_l == OP_SYNC) begin
                        refresh_req<=1'b1; refresh_base<=flashed_base; refresh_len<=flashed_len;
                    end
                    st<=S_IDLE;
                end
                S_REFUSE: begin refused<=1'b1; done<=1'b1; busy<=1'b0; st<=S_IDLE; end
                S_KICK: begin
                    if (!shift_busy && !shift_done) shift_go<=1'b1;
                    if (shift_done) st<=ret;
                end

                // --- READ_PAGE: 0x03 + 24-bit addr, clock 256 bytes into pbuf ---
                S_RCMD: begin flash_cs_n<=1'b0; tx_byte<=CMD_READ; rd_idx<=9'd0; ret<=S_RA2; st<=S_KICK; end
                S_RA2:  begin tx_byte<=addr_l[23:16]; ret<=S_RA1; st<=S_KICK; end
                S_RA1:  begin tx_byte<=addr_l[15:8];  ret<=S_RA0; st<=S_KICK; end
                S_RA0:  begin tx_byte<=addr_l[7:0];   ret<=S_RDATA; st<=S_KICK; end
                S_RDATA: begin
                    if (rd_idx==9'd256) st<=S_RCSUP;
                    else begin tx_byte<=8'h00; ret<=S_RCAP; st<=S_KICK; end
                end
                S_RCAP: begin   // rx_byte holds the byte just clocked in
                    rd_we<=1'b1; rd_waddr<=rd_idx[7:0]; rd_wdata<=rx_byte;
                    rd_idx<=rd_idx+1'b1; st<=S_RDATA;
                end
                S_RCSUP: begin flash_cs_n<=1'b1; st<=S_DONE; end

                // ================= boot-time descriptor load =================
                // Runs ONCE out of reset, before any command is served. Borrows
                // the flash bus (same bus_req/bus_gnt as commands) after preload,
                // reads DESC_BYTES from the descriptor block into db_buf, then
                // validates MAGIC+VERSION. On any mismatch (blank flash reads
                // 0xFF) descriptor_valid stays 0 -> pure legacy geometry.
                S_DBOOT: begin
                    bus_req<=1'b1;
                    if (bus_gnt) begin
                        db_idx<=7'd0;
                        st<=S_DCMD;
                    end
                end
                S_DCMD: begin flash_cs_n<=1'b0; tx_byte<=CMD_READ; ret<=S_DA2; st<=S_KICK; end
                S_DA2:  begin tx_byte<=DESC_PHYS[23:16];          ret<=S_DA1; st<=S_KICK; end
                S_DA1:  begin tx_byte<=DESC_PHYS[15:8];           ret<=S_DA0; st<=S_KICK; end
                S_DA0:  begin tx_byte<=DESC_PHYS[7:0];            ret<=S_DRD; st<=S_KICK; end
                S_DRD:  begin
                    if (db_idx==DESC_BYTES) begin flash_cs_n<=1'b1; st<=S_DFIN; end
                    else begin tx_byte<=8'h00; ret<=S_DCAP; st<=S_KICK; end
                end
                S_DCAP: begin
                    db_buf[db_idx[5:0]]<=rx_byte;
                    db_idx<=db_idx+1'b1;
                    st<=S_DRD;
                end
                S_DFIN: begin
                    bus_req<=1'b0; desc_loaded<=1'b1;
                    // Validate: MAGIC 'E','O','S','B' at 0..3, VERSION==1 at 4.
                    if (db_buf[0]==8'h45 && db_buf[1]==8'h4F &&
                        db_buf[2]==8'h53 && db_buf[3]==8'h42 && db_buf[4]==8'h01) begin
                        // Latch the 4 slot entries (8 bytes each from offset 0x08).
                        // entry: [0]=state [1]=size_code [4..6]=phys_base LE.
                        // Full bytes are masked to the needed width on read below to
                        // keep the extraction synthesis-friendly (no part-select of a
                        // memory word inline).
                        slot_state[1]<=db_buf[6'h08][1:0];  slot_szc[1]<=db_buf[6'h09][1:0];
                        slot_base[1] <={db_buf[6'h0E],db_buf[6'h0D],db_buf[6'h0C]};
                        slot_state[2]<=db_buf[6'h10][1:0];  slot_szc[2]<=db_buf[6'h11][1:0];
                        slot_base[2] <={db_buf[6'h16],db_buf[6'h15],db_buf[6'h14]};
                        slot_state[3]<=db_buf[6'h18][1:0];  slot_szc[3]<=db_buf[6'h19][1:0];
                        slot_base[3] <={db_buf[6'h1E],db_buf[6'h1D],db_buf[6'h1C]};
                        slot_state[4]<=db_buf[6'h20][1:0];  slot_szc[4]<=db_buf[6'h21][1:0];
                        slot_base[4] <={db_buf[6'h26],db_buf[6'h25],db_buf[6'h24]};
                        descriptor_valid<=1'b1;
                    end else begin
                        descriptor_valid<=1'b0;   // blank/invalid -> legacy
                    end
                    // LED bank colors live in the SAME descriptor block: a color
                    // sub-magic 'C','O','L','R' at 0x2C..0x2F, then 4x RGB at 0x30.
                    // If the sub-magic is absent (older descriptor / blank) the
                    // colors default to FF,FF,FF = unset -> LED off.
                    if (db_buf[6'h2C]==8'h43 && db_buf[6'h2D]==8'h4F &&
                        db_buf[6'h2E]==8'h4C && db_buf[6'h2F]==8'h52) begin
                        bank1_rgb<={db_buf[6'h30],db_buf[6'h31],db_buf[6'h32]};
                        bank2_rgb<={db_buf[6'h33],db_buf[6'h34],db_buf[6'h35]};
                        bank3_rgb<={db_buf[6'h36],db_buf[6'h37],db_buf[6'h38]};
                        bank4_rgb<={db_buf[6'h39],db_buf[6'h3A],db_buf[6'h3B]};
                    end else begin
                        bank1_rgb<=24'hFFFFFF; bank2_rgb<=24'hFFFFFF;
                        bank3_rgb<=24'hFFFFFF; bank4_rgb<=24'hFFFFFF;
                    end
                    bus_req<=1'b0;
                    st<=S_IDLE;
                end


                default: st<=S_IDLE;
            endcase
        end
    end
    // ---- commit supervisor FSM (clk_sd) --------------------------------------
    always @(posedge clk or negedge cold_rstn) begin
        if (!cold_rstn) begin
            cst<=CS_IDLE; commit_active<=1'b0; commit_busy<=1'b0; commit_done<=1'b0;
            commit_err<=1'b0; cbank<=4'd0; cpages<=13'd0; cpg<=13'd0; cfill<=9'd0;
            cstep<=2'd0; sup_cmd_stb<=1'b0; sup_cmd_op<=2'd0; sup_cmd_page<=13'd0;
            sup_pb_wr<=1'b0; sup_pb_addr<=8'd0; sup_pb_din<=8'd0; scr_rd<=1'b0; scr_raddr<=21'd0;
        end else begin
            commit_done <= 1'b0;
            sup_cmd_stb <= 1'b0;
            sup_pb_wr   <= 1'b0;
            scr_rd      <= 1'b0;
            case (cst)
                CS_IDLE: begin
                    commit_active<=1'b0; commit_busy<=1'b0;
                    if (commit_go) begin
                        cbank<=commit_bank; cpages<=commit_pages; cpg<=13'd0;
                        commit_active<=1'b1; commit_busy<=1'b1; commit_err<=1'b0;
                        cstep<=2'd0; cst<=CS_ERASE;
                    end
                end
                CS_ERASE: case (cstep)
                    2'd0: begin sup_cmd_op<=OP_ERASE; cstep<=2'd1; end
                    2'd1: begin sup_cmd_stb<=1'b1;    cstep<=2'd2; end
                    2'd2: if (busy) cstep<=2'd3;
                    2'd3: if (done) begin
                              if (refused) cst<=CS_ERR;
                              else begin cfill<=9'd0; cstep<=2'd0; cst<=CS_FILL; end
                          end
                endcase
                CS_FILL: case (cstep)
                    2'd0: if (!scr_busy) begin
                              scr_rd    <= 1'b1;
                              scr_raddr <= {cpg[12:0], cfill[7:0]};
                              cstep     <= 2'd1;
                          end
                    2'd1: if (scr_rvalid) begin
                              sup_pb_wr   <= 1'b1;
                              sup_pb_addr <= cfill[7:0];
                              sup_pb_din  <= scr_rdata;
                              cstep       <= 2'd2;
                          end
                    2'd2: if (cfill == 9'd255) begin cstep<=2'd0; cst<=CS_PROG; end
                          else begin cfill<=cfill+1'b1; cstep<=2'd0; end
                endcase
                CS_PROG: case (cstep)
                    2'd0: begin sup_cmd_op<=OP_PROG; sup_cmd_page<=cpg; cstep<=2'd1; end
                    2'd1: begin sup_cmd_stb<=1'b1; cstep<=2'd2; end
                    2'd2: if (busy) cstep<=2'd3;
                    2'd3: if (done) begin
                              if (refused) cst<=CS_ERR;
                              else begin
                                  cpg<=cpg+1'b1;
                                  if ((cpg+1'b1) >= cpages) begin cstep<=2'd0; cst<=CS_SYNC; end
                                  else begin cfill<=9'd0; cstep<=2'd0; cst<=CS_FILL; end
                              end
                          end
                endcase
                CS_SYNC: case (cstep)
                    2'd0: begin sup_cmd_op<=OP_SYNC; cstep<=2'd1; end
                    2'd1: begin sup_cmd_stb<=1'b1; cstep<=2'd2; end
                    2'd2: if (busy) cstep<=2'd3;
                    2'd3: if (done) cst<=CS_DONE;
                endcase
                CS_DONE: begin
                    commit_active<=1'b0; commit_busy<=1'b0; commit_done<=1'b1; cst<=CS_IDLE;
                end
                CS_ERR: begin
                    commit_active<=1'b0; commit_busy<=1'b0; commit_err<=1'b1;
                    commit_done<=1'b1; cst<=CS_IDLE;
                end
                default: cst<=CS_IDLE;
            endcase
        end
    end

endmodule
