Darkone83/EOS/(commit log)

2026-07-02 1.0.0 Rollout
    1.0.0 Release
    [BOM.xlsx, PickAndPlace.xlsx]
2026-07-21 Correct resistor value from 22 kΩ to 22 Ω
2026-07-30 1.0.1
    See changelog
    Added BANK LED Support
    SD Card Support
    Comment Cleanup
2026-08-02 1.0.3
    X-HD support
    V2 Carrier
    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
    [BOM.xlsx, BOM_V2.xlsx, PickAndPlace.xlsx, PickAndPlace_V2.xlsx]
2026-08-11 Updater additions
    Added LED bank control
    Updated file sorting
2026-08-15 1.0.4
    Added EOS Script Editor
    Added Gateware support for EOS script
    Adjusted flasg timins for XTX and Windbond boards
    Simplified HDMI HUD layout
    Updated gen_hud.py for new HUD layout
2026-08-17 EOS Script updates
    Updated script handling and loading
    Updated the EOS Script Editor:
    Added a new LED Studio
    a GPIO / PWM Studio
    and an I2C Studio
2026-08-30 V2 Correction
    PCB correction for V2
2026-09-10 1.0.5
    SM bus revisions, updater updates, HD rework
    [eos_bank_led.v, eos_exp_engine.v, eos_gfx.cpp, eos_gpio_studio.py, eos_hd.v, eos_hdmi_top.v, eos_i2c.v]
2026-09-15 1.0.5-1
    HD Freeze fix
    Updater reporting
    [eos_hdmi_top.v, eos_lpc_loader.v, main.cpp]
2026-09-16 V2 Refresh
    Added Filtering and pull-up resistors
    [BOM_V2.xlsx, PickAndPlace_V2.xlsx]
2026-09-19 Cleanup
    Updater UI and codebase cleanup
    Editor I2C fix
    GUI packer
    [dd_net.cpp, eos_backup.cpp, eos_backup.h, eos_bank.cpp, eos_bank.h, eos_config.cpp, eos_config.h, eos_file.cpp]
