Darkone83/EOS/(notices)

Notices in the files:
Source/src/eos_exp_engine.v:
path, GPLv3) with a transaction layer + buffers, so the interpreter issues
